claudiusmarius/ARROSEUR-AUTOMATIQUE-NEW-CONCEPT-DFTA211/mini pompe.png

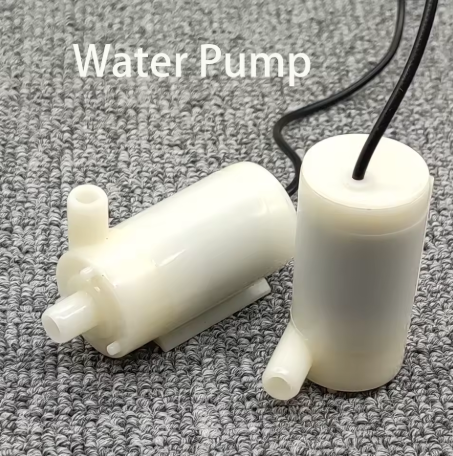
mini pompe.png
