claudiusmarius/ARROSEUR-AUTOMATIQUE-NEW-CONCEPT-DFTA211/ListeComposants.jpg.png

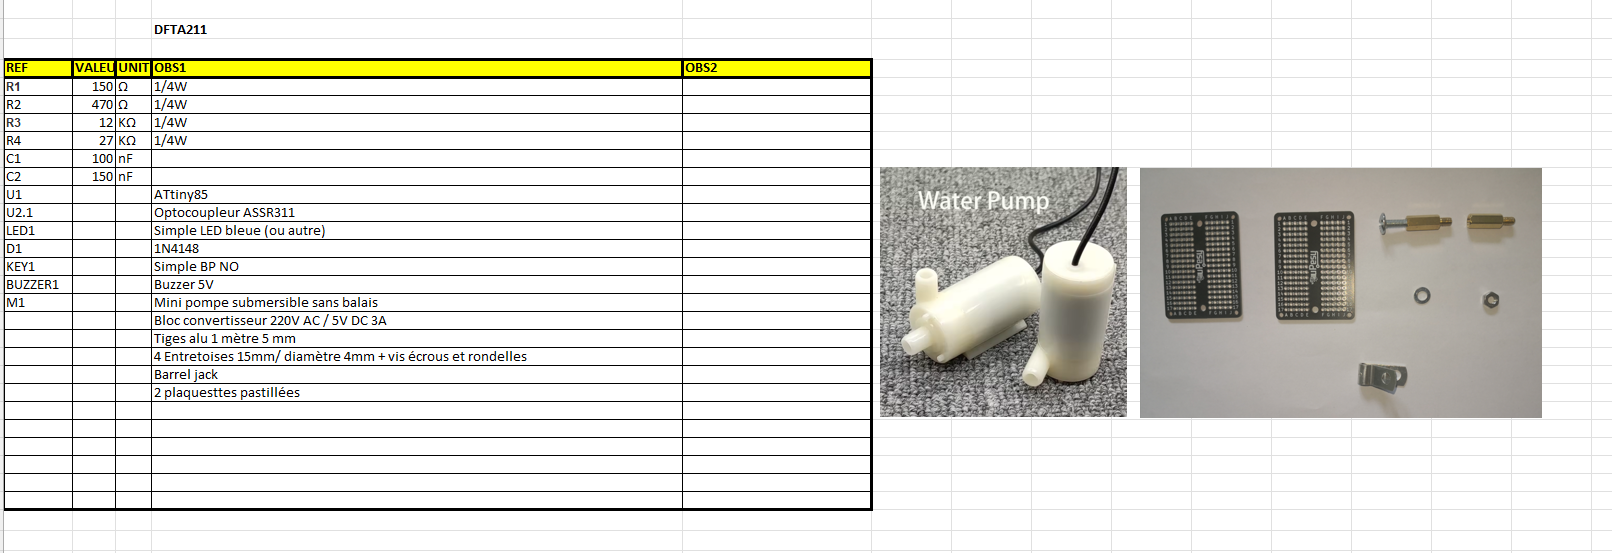
ListeComposants.jpg.png
