claudiusmarius/ARROSEUR-AUTOMATIQUE-NEW-CONCEPT-DFTA211/Schematic_DFTA211.pdf

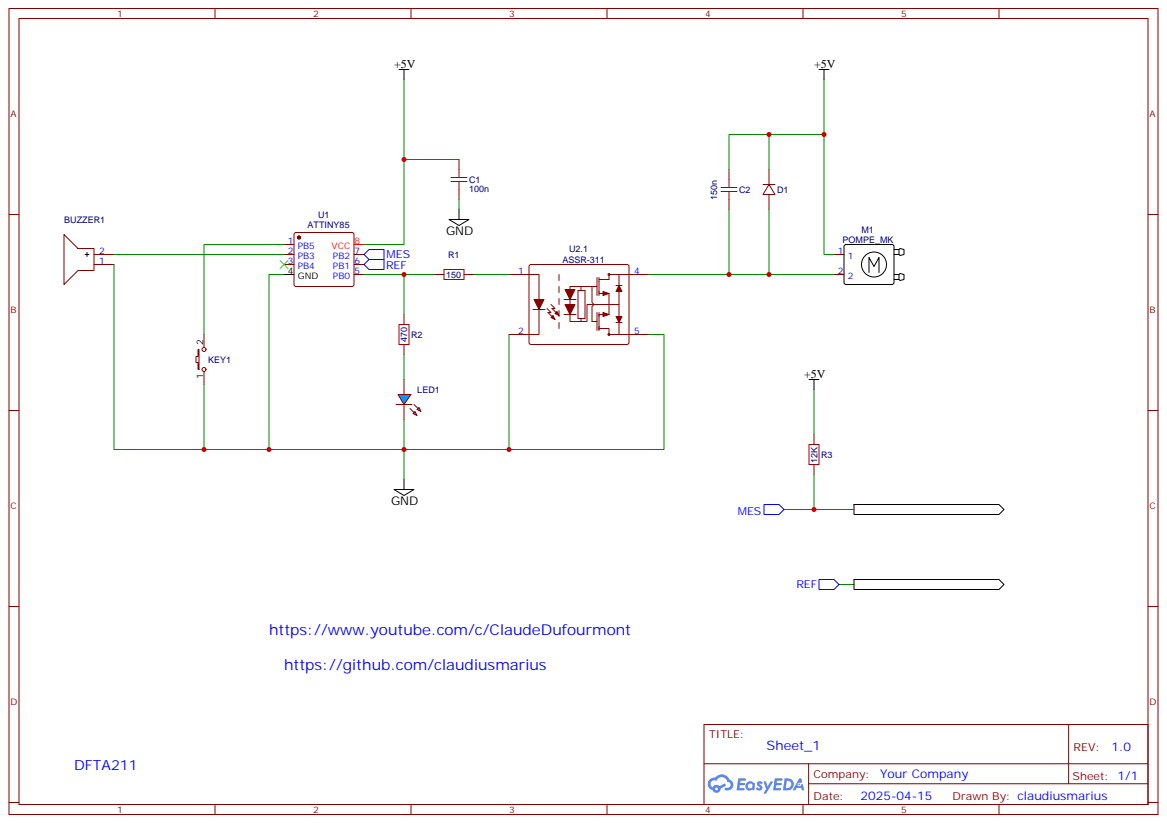
[picture p3: page 1]

https://www.youtube.com/c/ClaudeDufourmont

https://github.com/claudiusmarius
